Lee-Stone/orangepi-ros2-car/assets/44.png

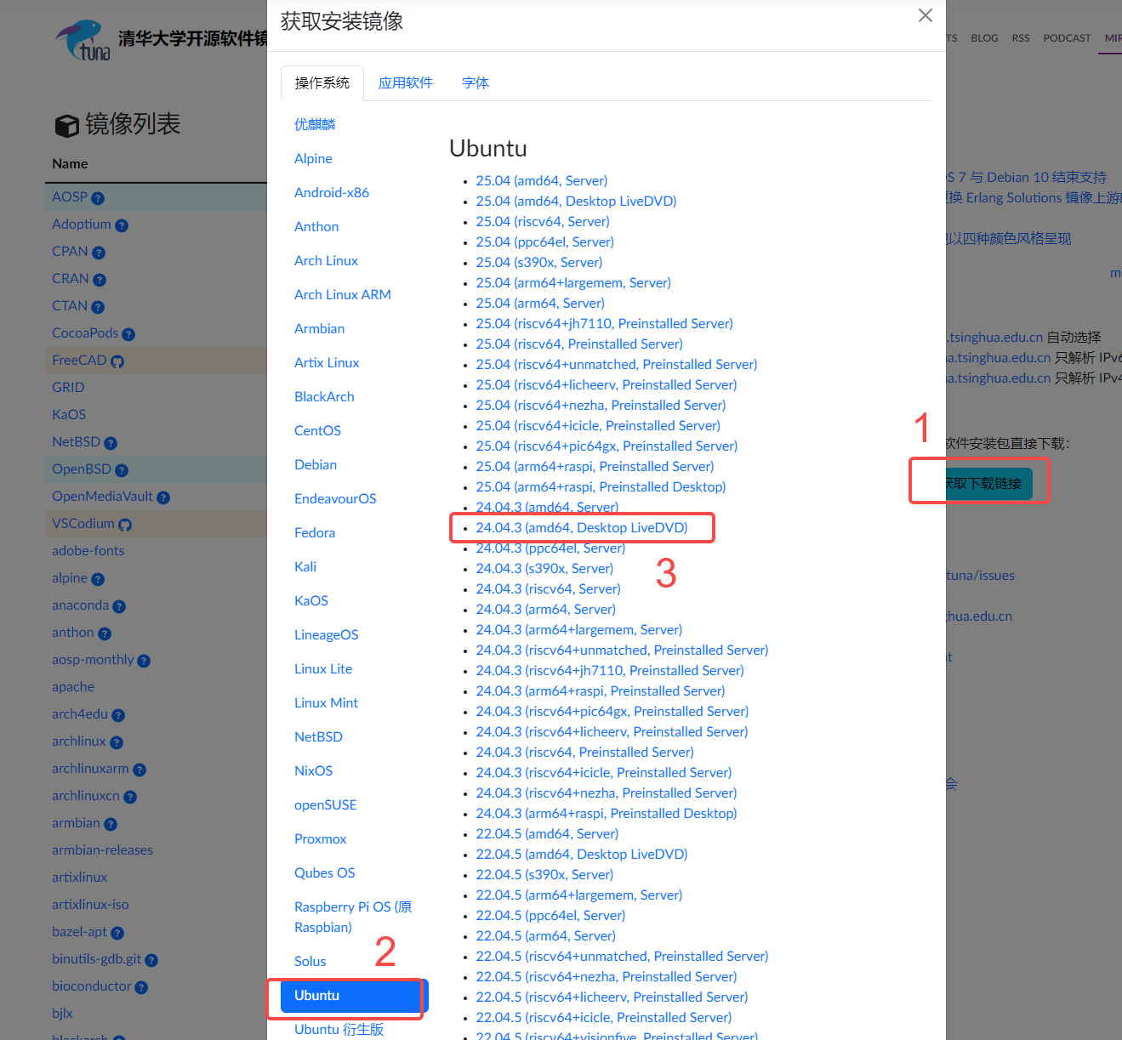
assets/44.png
