Lee-Stone/orangepi-ros2-car/assets/47.png

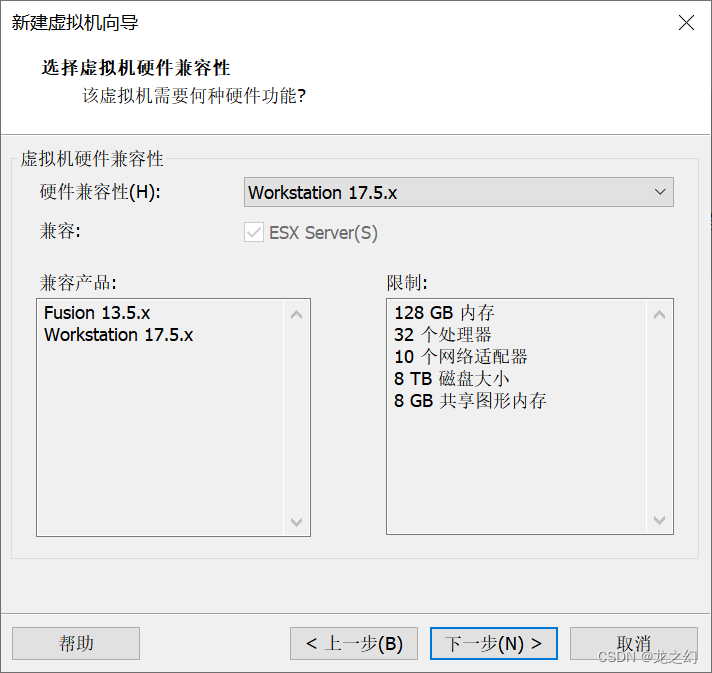
assets/47.png
