Lee-Stone/orangepi-ros2-car/assets/89.png

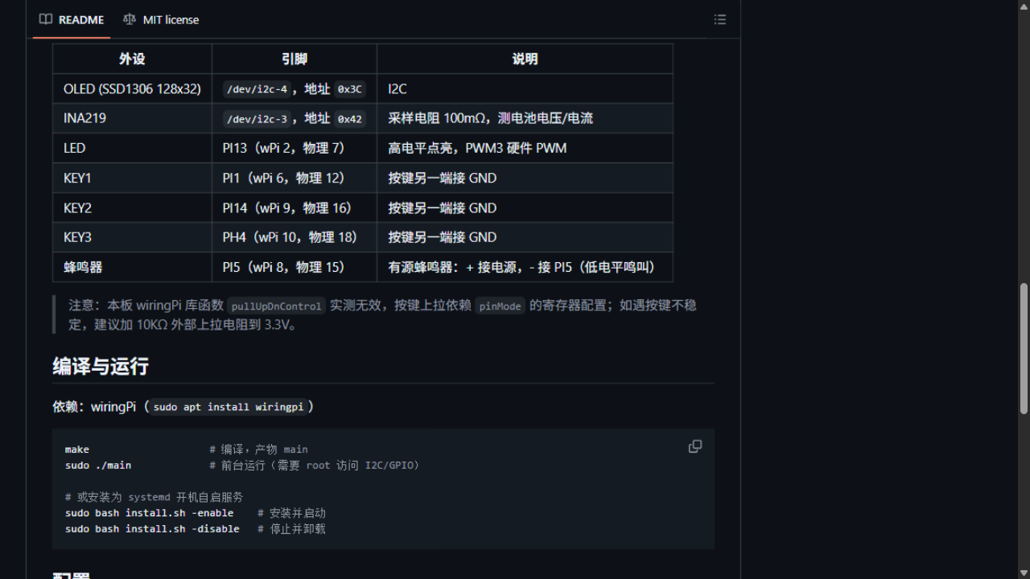
assets/89.png
