Lee-Stone/orangepi-ros2-car/assets/145.png

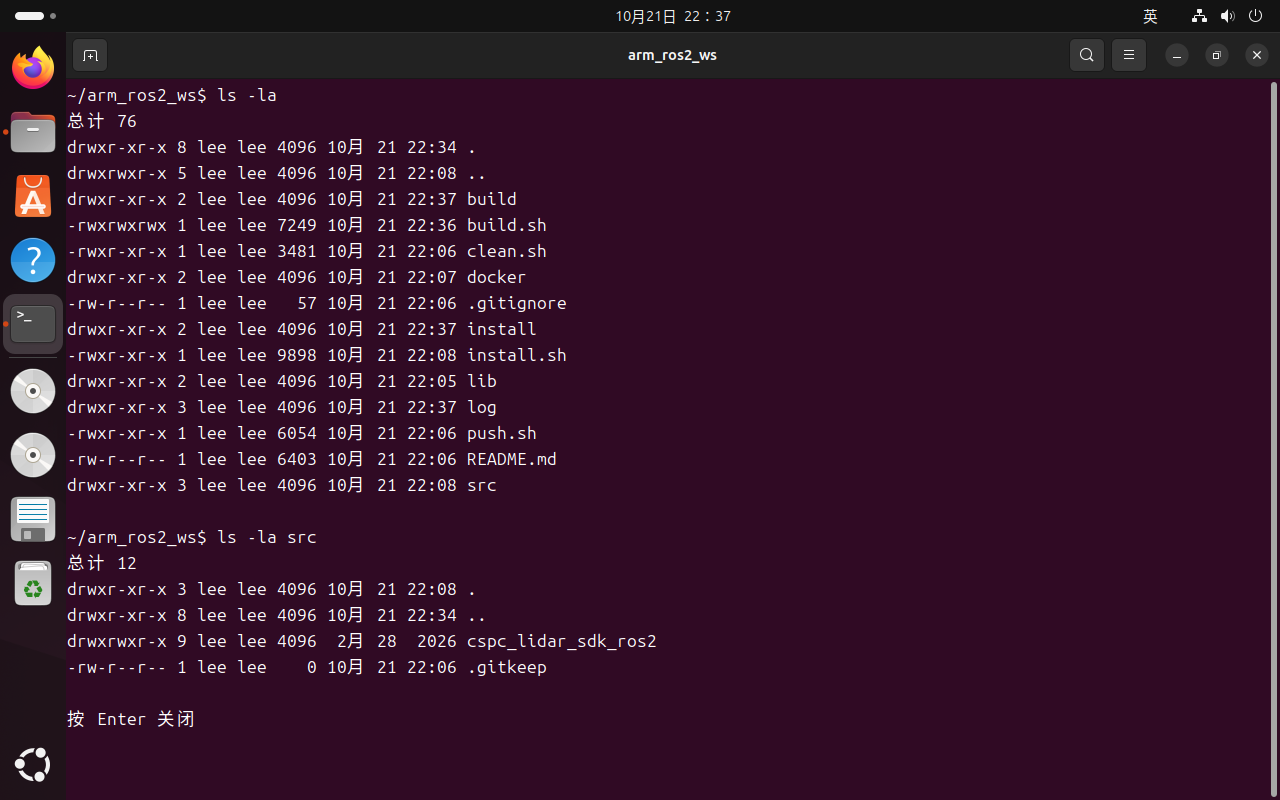
assets/145.png
