Lee-Stone/orangepi-ros2-car/assets/149.png

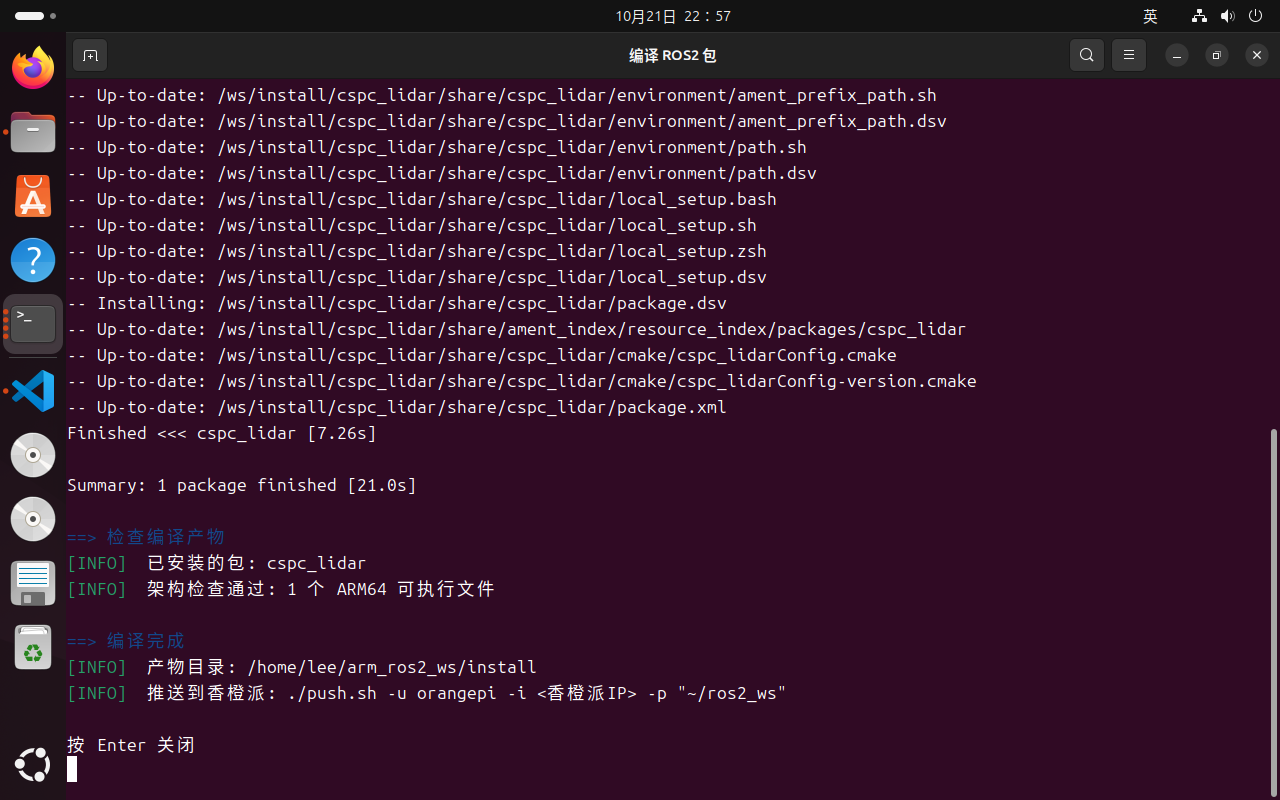
assets/149.png
