Lee-Stone/orangepi-ros2-car/assets/230.png

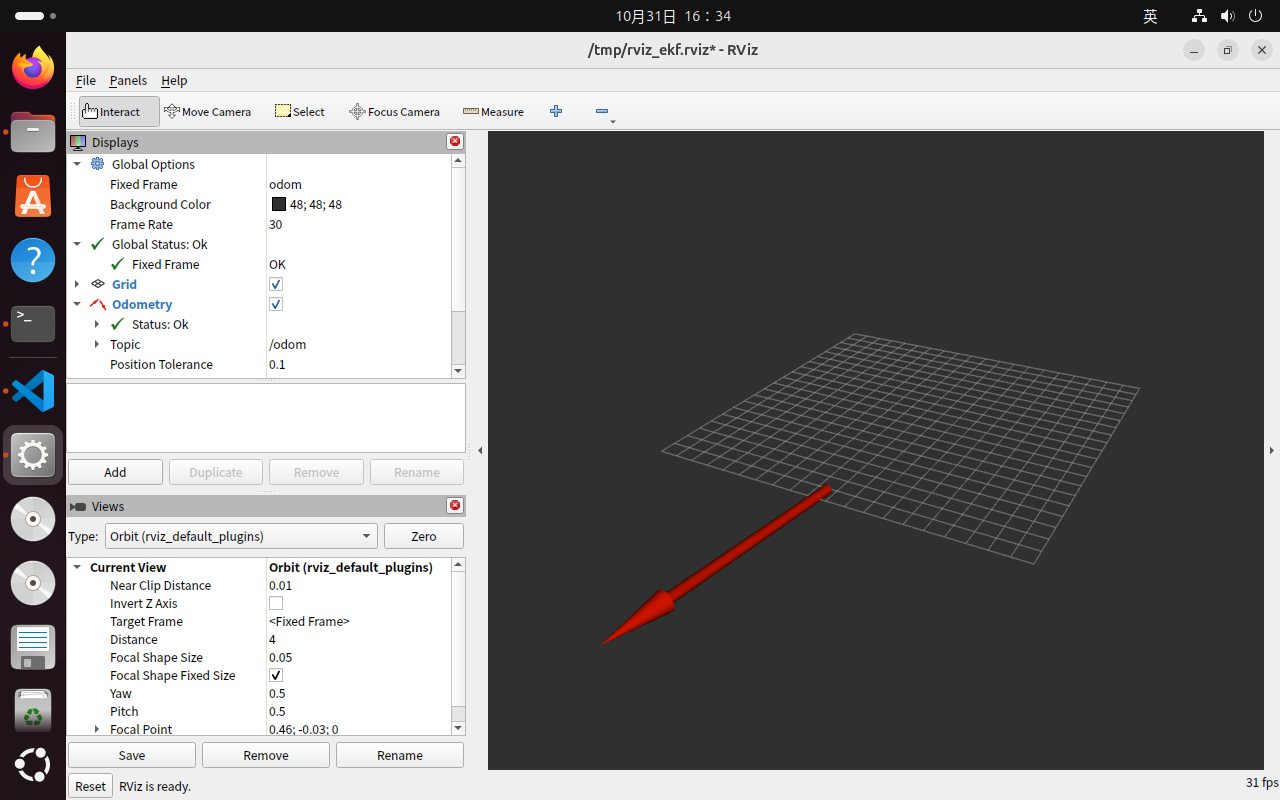
assets/230.png
