Lee-Stone/orangepi-ros2-car/assets/258.png

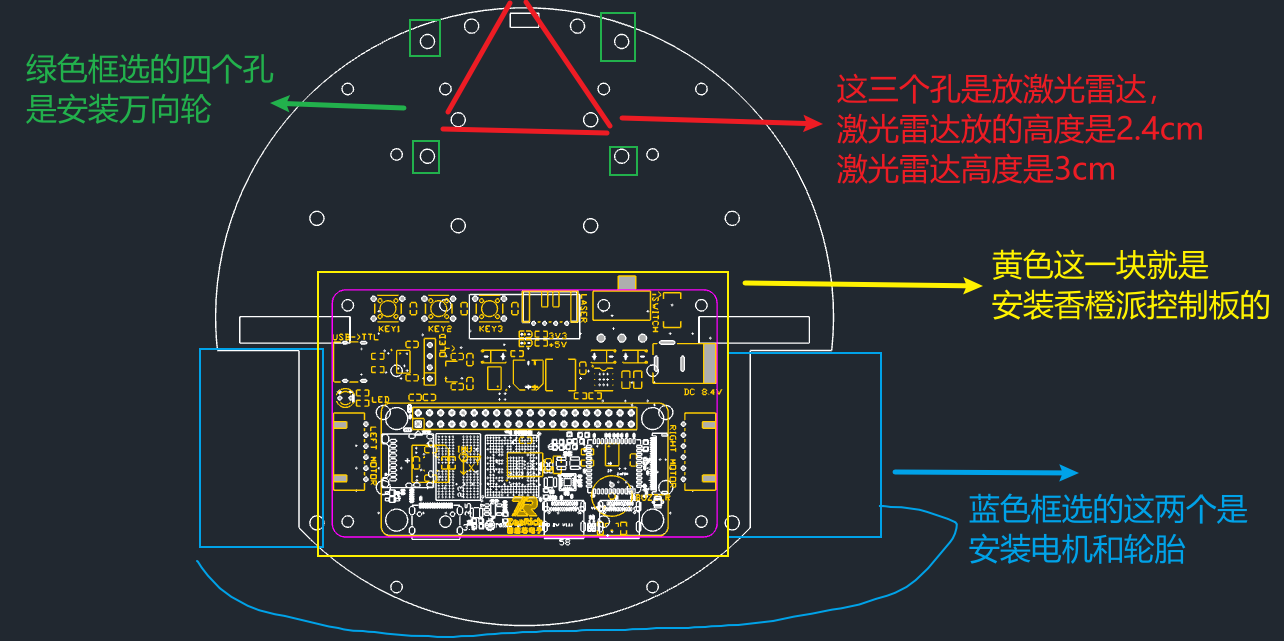
assets/258.png
