Lee-Stone/orangepi-ros2-car/assets/259.png

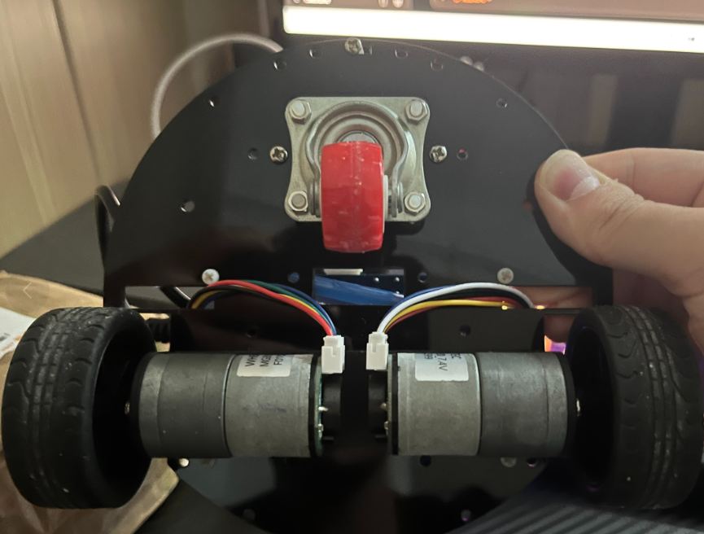
assets/259.png
