Lee-Stone/orangepi-ros2-car/assets/262.png

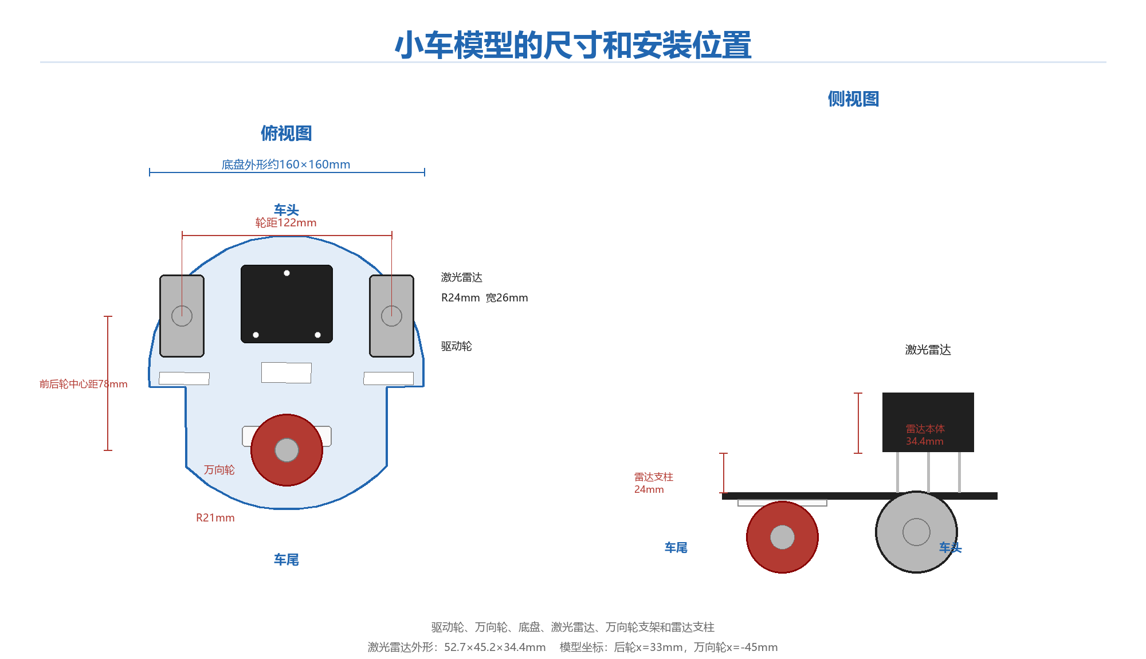
assets/262.png
