Lee-Stone/orangepi-ros2-car/assets/309.png

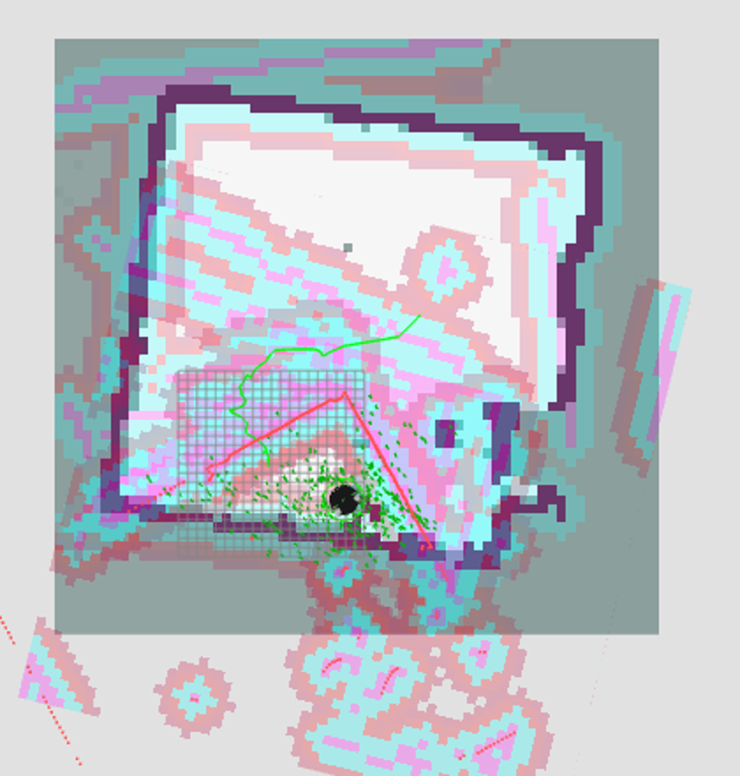
assets/309.png
