Lee-Stone/orangepi-ros2-car/assets/322.png

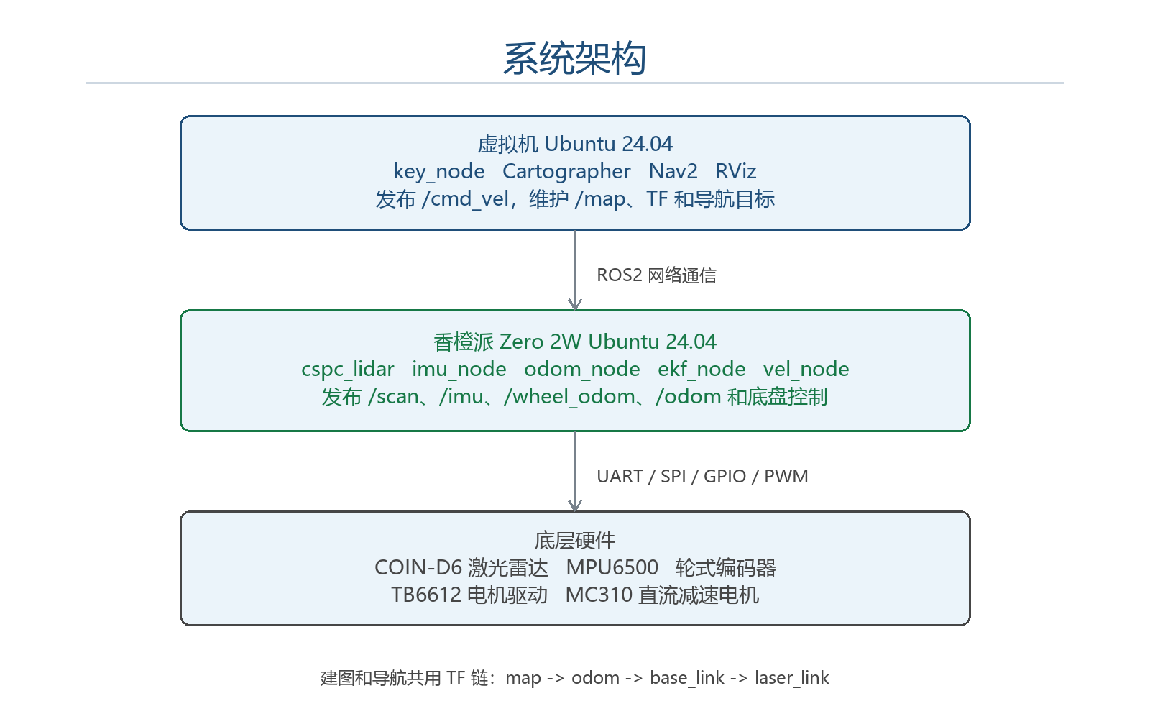
assets/322.png
