Lee-Stone/orangepi-ros2-car/vmware_ros2_ws/src/car_pkg/urdf/base_plate.stl

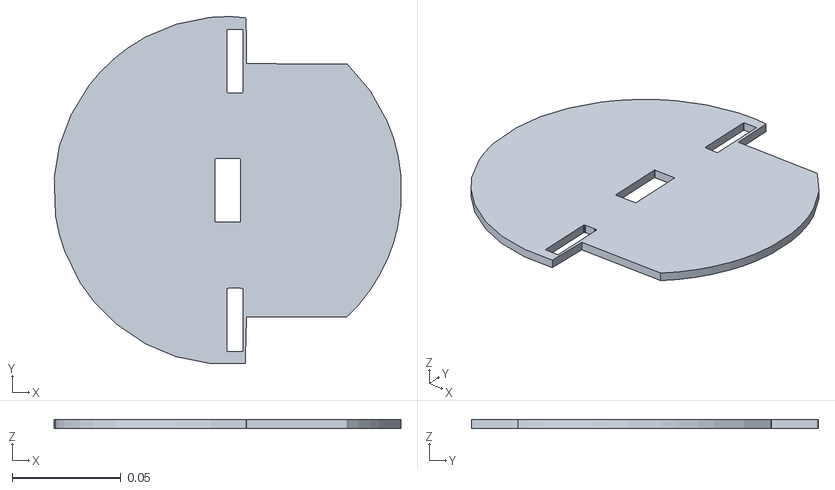
[picture p312: CAD file, 2026-11-04]
vmware_ros2_ws/src/car_pkg/urdf/base_plate.stl
0.159 x 0.159 x 0.004
