Lee-Stone/orangepi-ros2-car/hardware/香橙派ROS2控制板-原理图.pdf

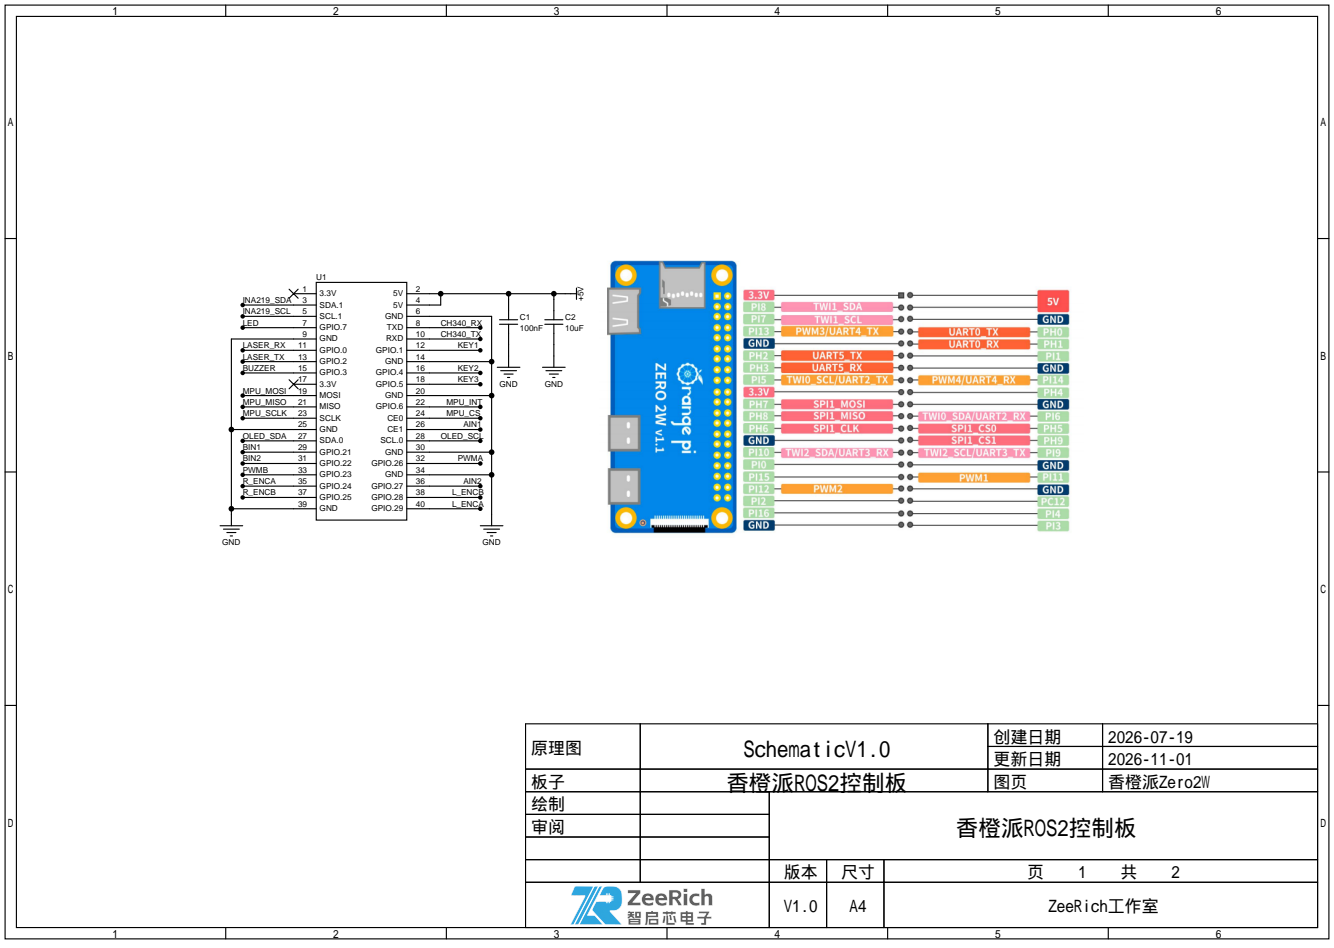
[picture p313: page 1]

原理图 | SchematicV1.0 | 创建日期 | 2026-07-19

更新日期 | 2026-11-01

板子 | 香橙派ROS2控制板 | 图页 | 香橙派Zero2W
绘制 | | 香橙派ROS2控制板
审阅

V1.0 | A4 | ZeeRich工作室

USB转串口 | 电流采样电路 | 用户按键 | 电机驱动 GND

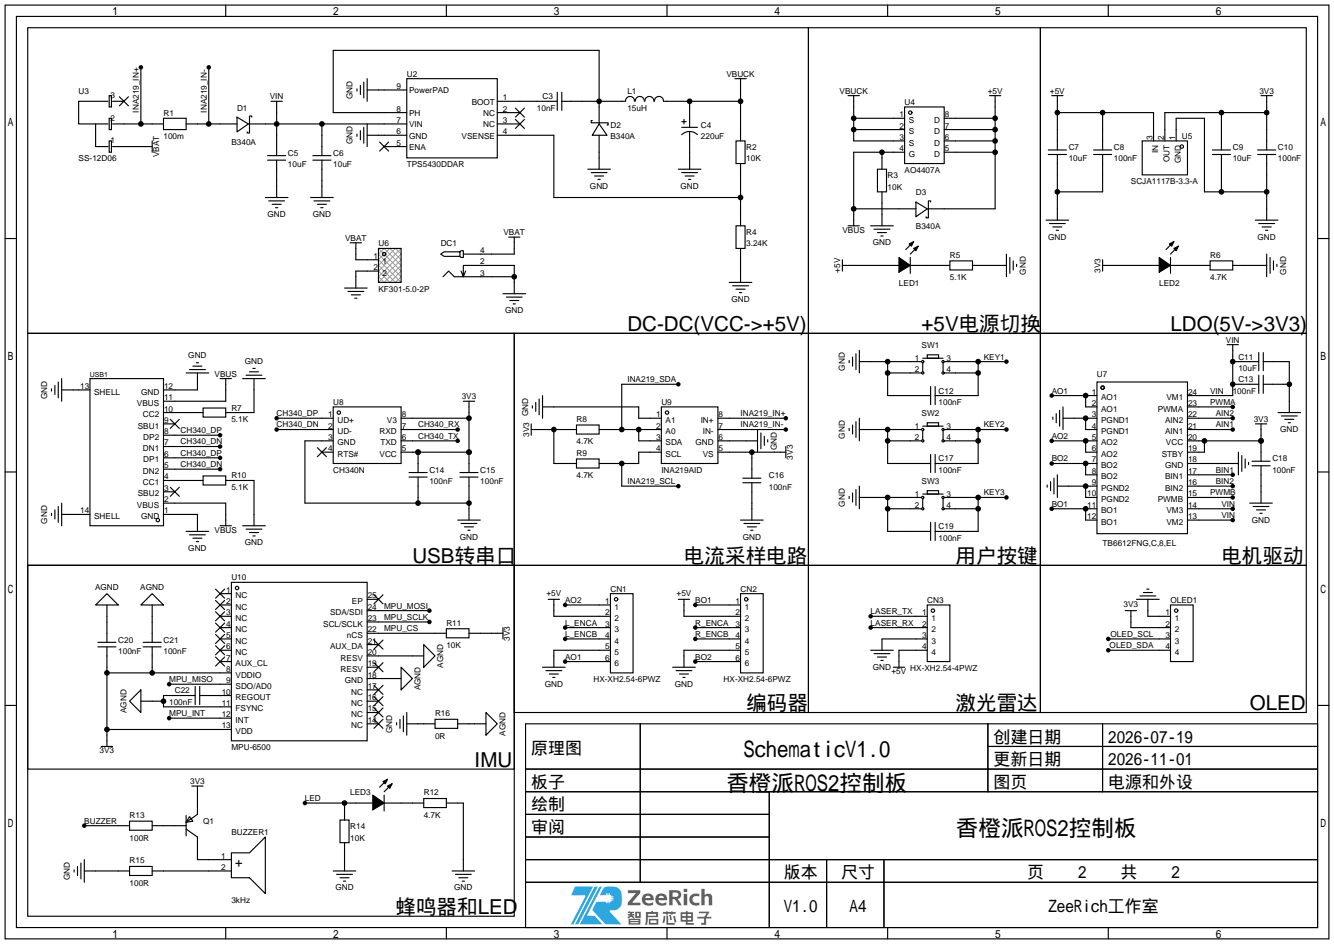
[picture p314: page 2]

原理图 | SchematicV1.0 | 创建日期 | 2026-07-19
板子 | 香橙派ROS2控制板 | 图页 | 电源和外设
绘制 | | 香橙派ROS2控制板
审阅

更新日期 | 2026-11-01

V1.0 | A4 | ZeeRich工作室
