Lee-Stone/orangepi-ros2-car/hardware/香橙派Zero2W-原理图.pdf

D | D

# 1.Note that the voltage of SOC GPIO must matches the

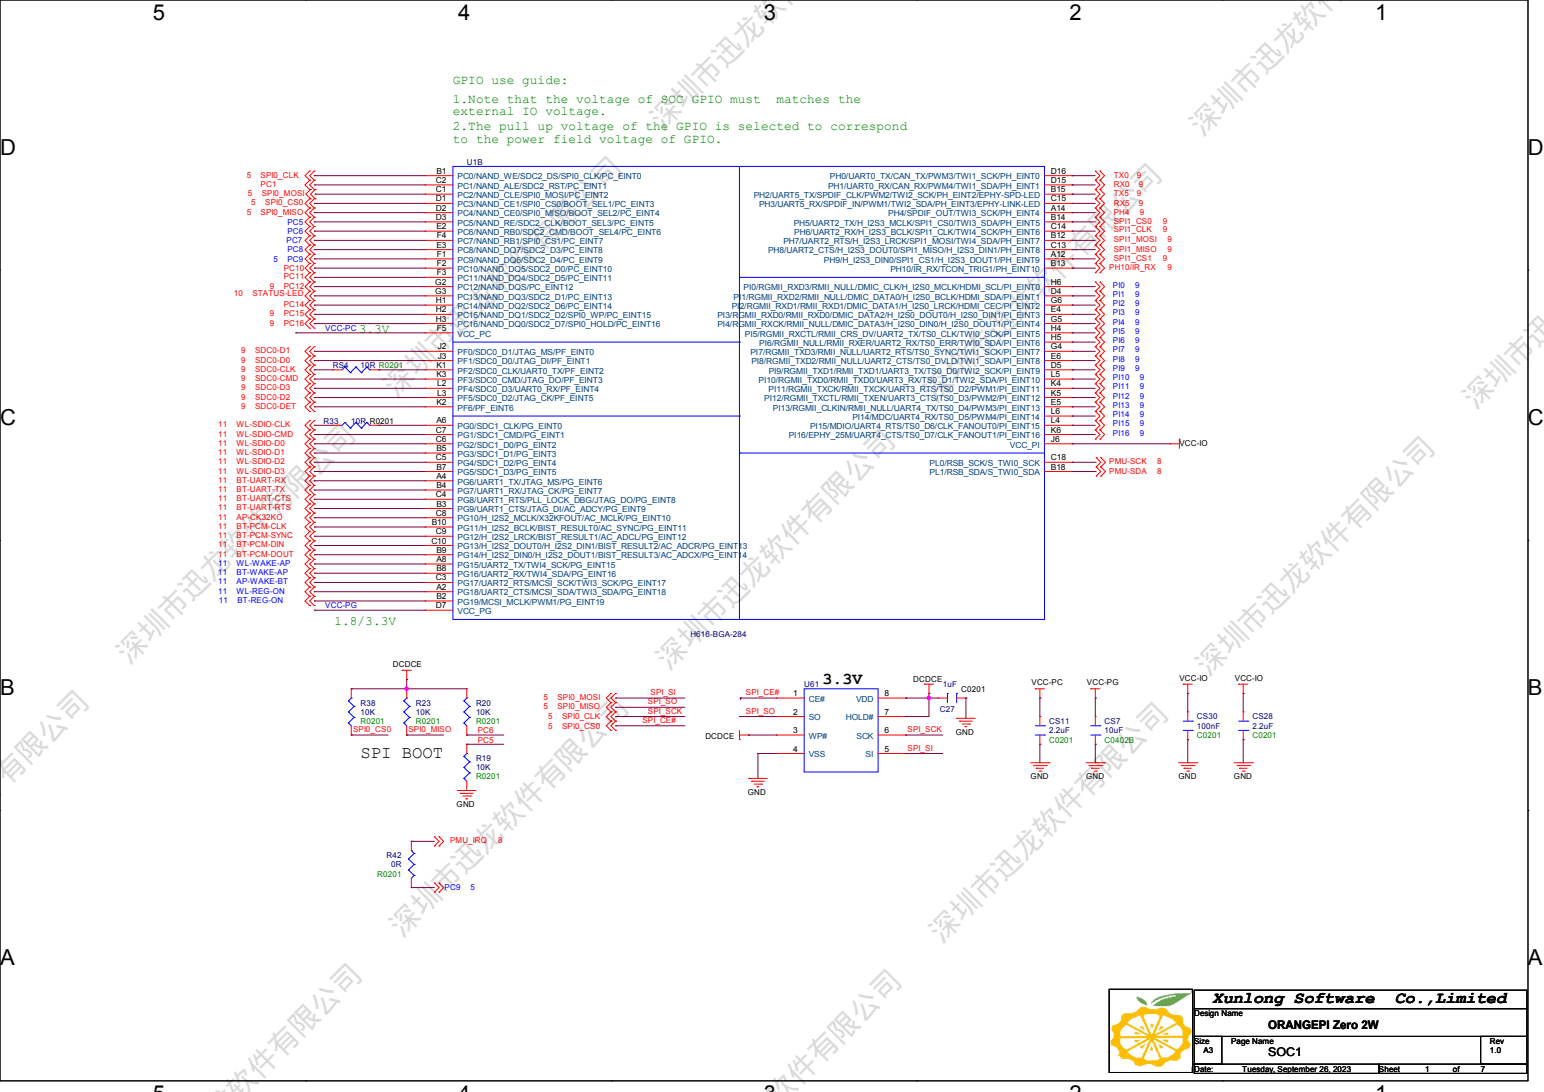
[picture p315: page 1]

深圳市迅龙软件有限公司 深圳市迅龙软件有限公司 深圳市迅龙软件有限公司 深圳市迅龙软件有限公司 深圳市迅龙软件有限公司 深圳市迅龙软件有限公司 深圳市迅龙软件有限公司 深圳市迅龙软件有限公司 深圳市迅龙软件有限公司 深圳市迅龙软件有限公司 深圳市迅龙软件有限公司 深圳市迅龙软件有限公司 深圳市迅龙软件有限公司 深圳市迅龙软件有限公司 深圳市迅龙软件有限公司

GPIO use guide:
external IO voltage.
2.The pull up voltage of the GPIO is selected to correspond
to the power field voltage of GPIO.

Xunlong Software Co.,Limited

D | D

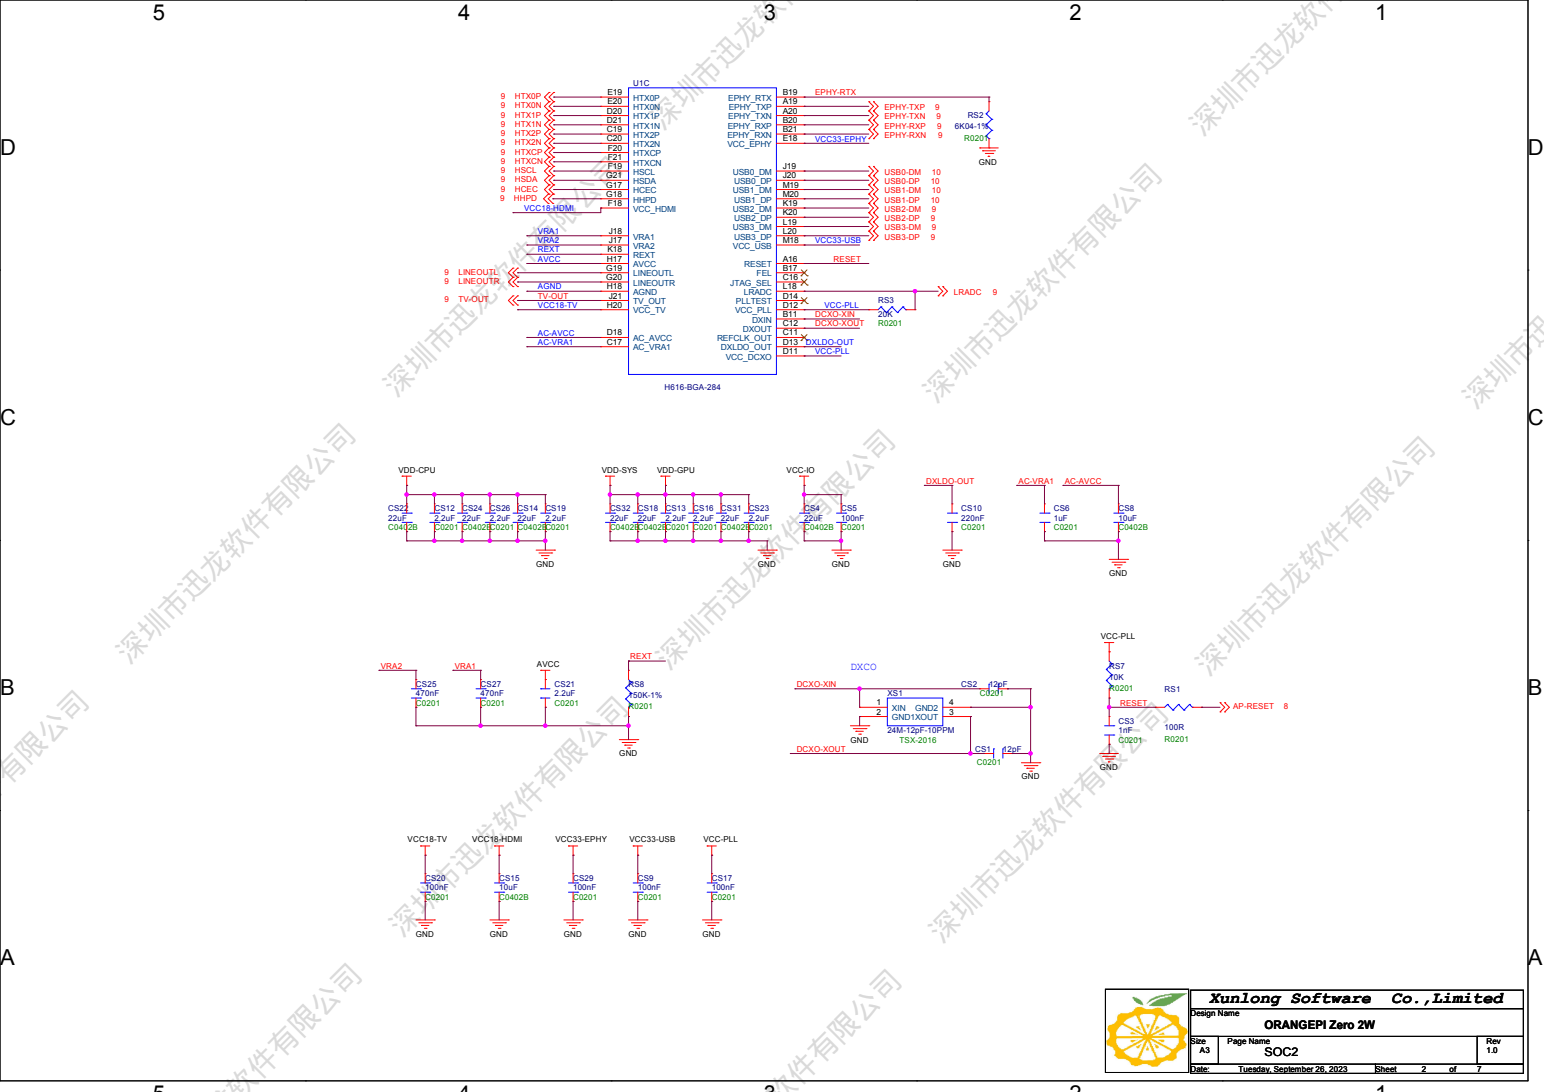
[picture p316: page 2]

深圳市迅龙软件有限公司 深圳市迅龙软件有限公司 深圳市迅龙软件有限公司 深圳市迅龙软件有限公司 深圳市迅龙软件有限公司 深圳市迅龙软件有限公司 深圳市迅龙软件有限公司 深圳市迅龙软件有限公司 深圳市迅龙软件有限公司 深圳市迅龙软件有限公司 深圳市迅龙软件有限公司 深圳市迅龙软件有限公司 深圳市迅龙软件有限公司 深圳市迅龙软件有限公司 深圳市迅龙软件有限公司

Xunlong Software Co.,Limited

D | D

# LPDDR4

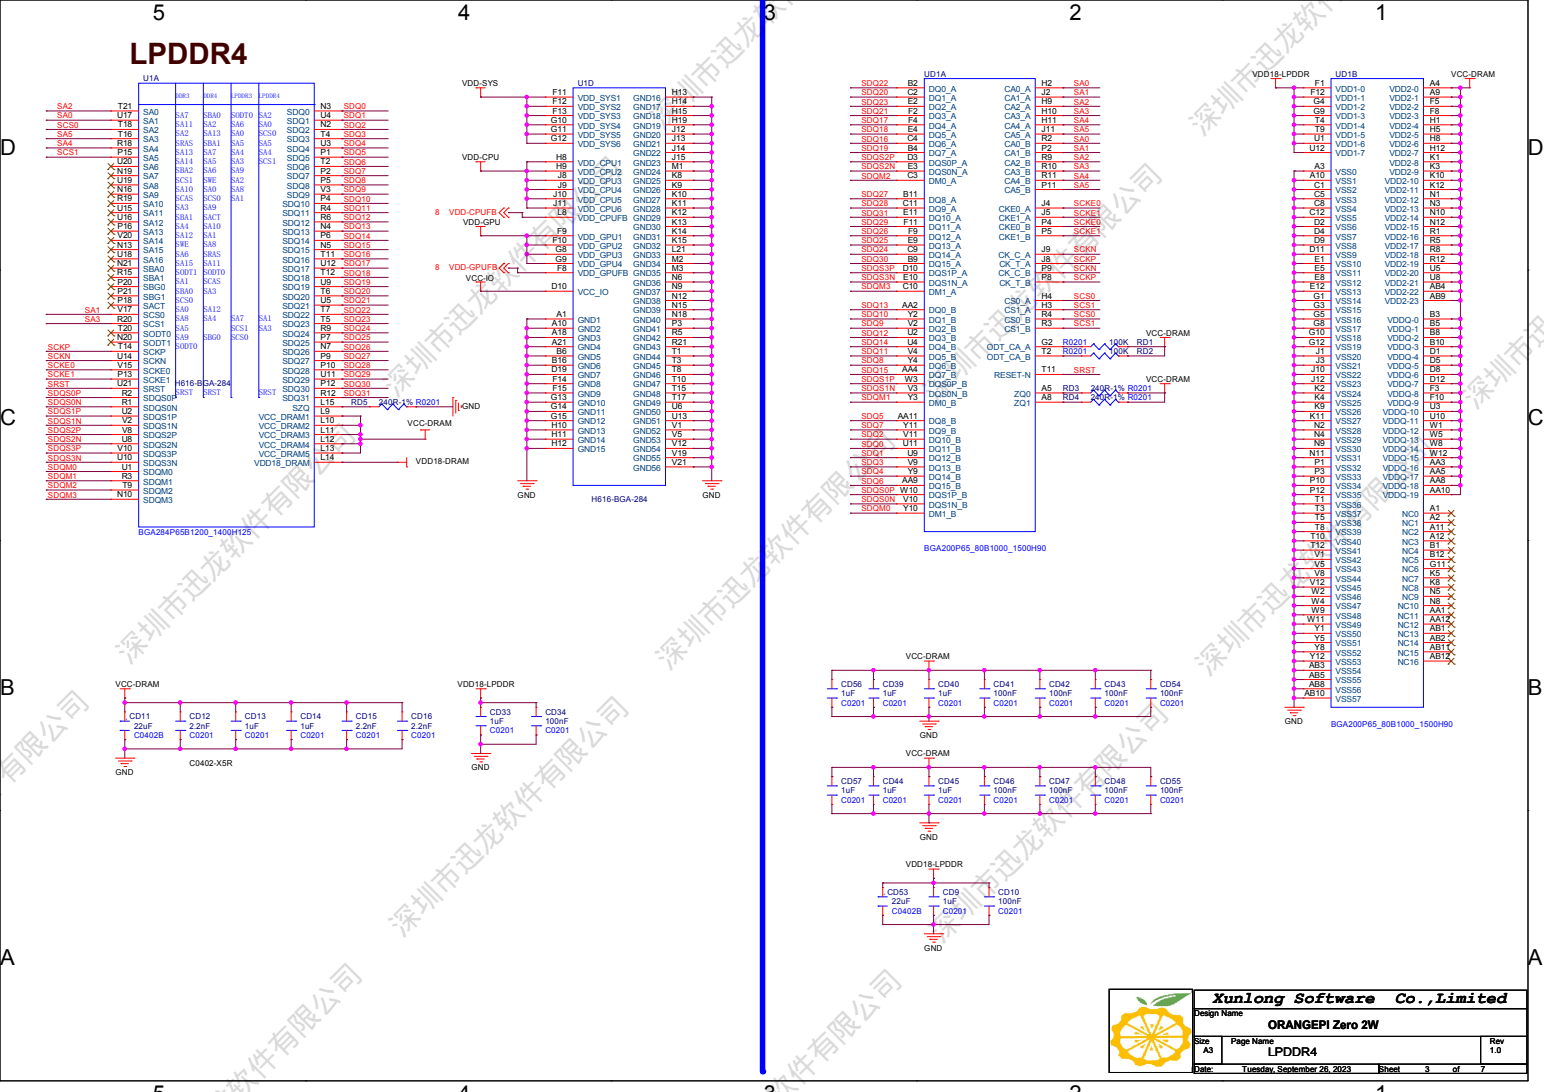
[picture p317: page 3]

深圳市迅龙软件有限公司 深圳市迅龙软件有限公司 深圳市迅龙软件有限公司 深圳市迅龙软件有限公司 深圳市迅龙软件有限公司 深圳市迅龙软件有限公司 深圳市迅龙软件有限公司 深圳市迅龙软件有限公司 深圳市迅龙软件有限公司 深圳市迅龙软件有限公司 深圳市迅龙软件有限公司 深圳市迅龙软件有限公司 深圳市迅龙软件有限公司 深圳市迅龙软件有限公司 深圳市迅龙软件有限公司

Xunlong Software Co.,Limited

### 1.0uH@2ADCR<0.1R

# AXP313A

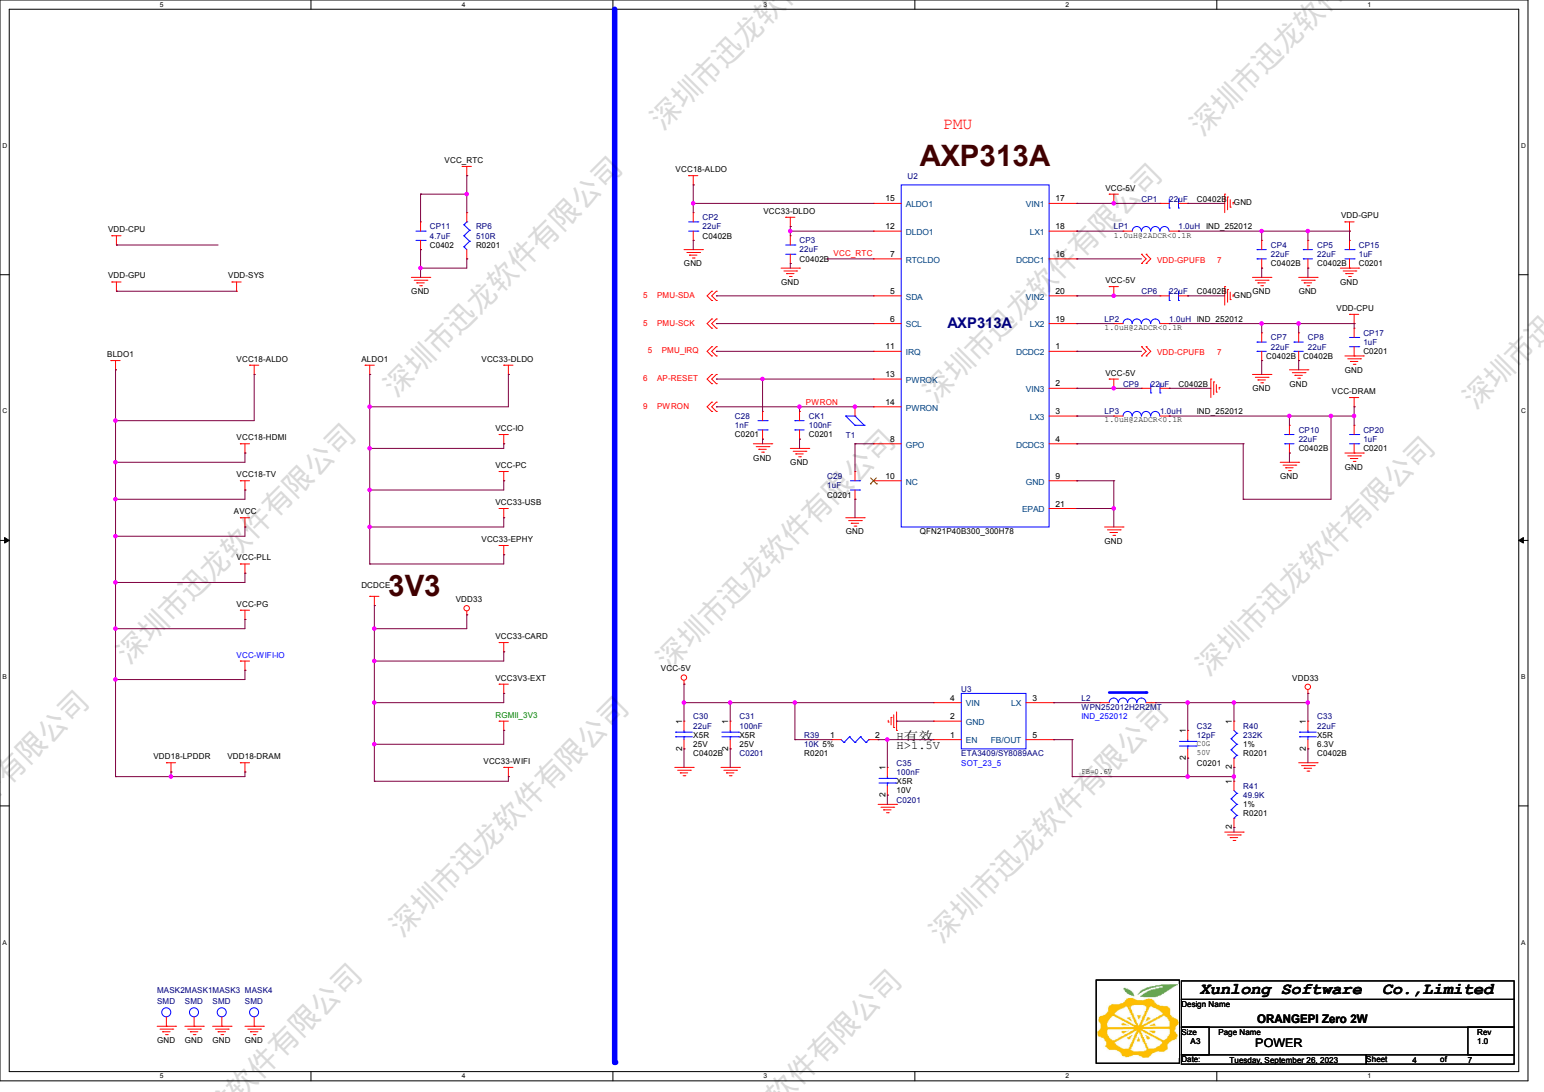
[picture p318: page 4]

深圳市迅龙软件有限公司 深圳市迅龙软件有限公司 深圳市迅龙软件有限公司 深圳市迅龙软件有限公司 深圳市迅龙软件有限公司 深圳市迅龙软件有限公司 深圳市迅龙软件有限公司 深圳市迅龙软件有限公司 深圳市迅龙软件有限公司 深圳市迅龙软件有限公司 深圳市迅龙软件有限公司 深圳市迅龙软件有限公司 深圳市迅龙软件有限公司 深圳市迅龙软件有限公司 深圳市迅龙软件有限公司

Xunlong Software Co.,Limited

D | D

# T CARD

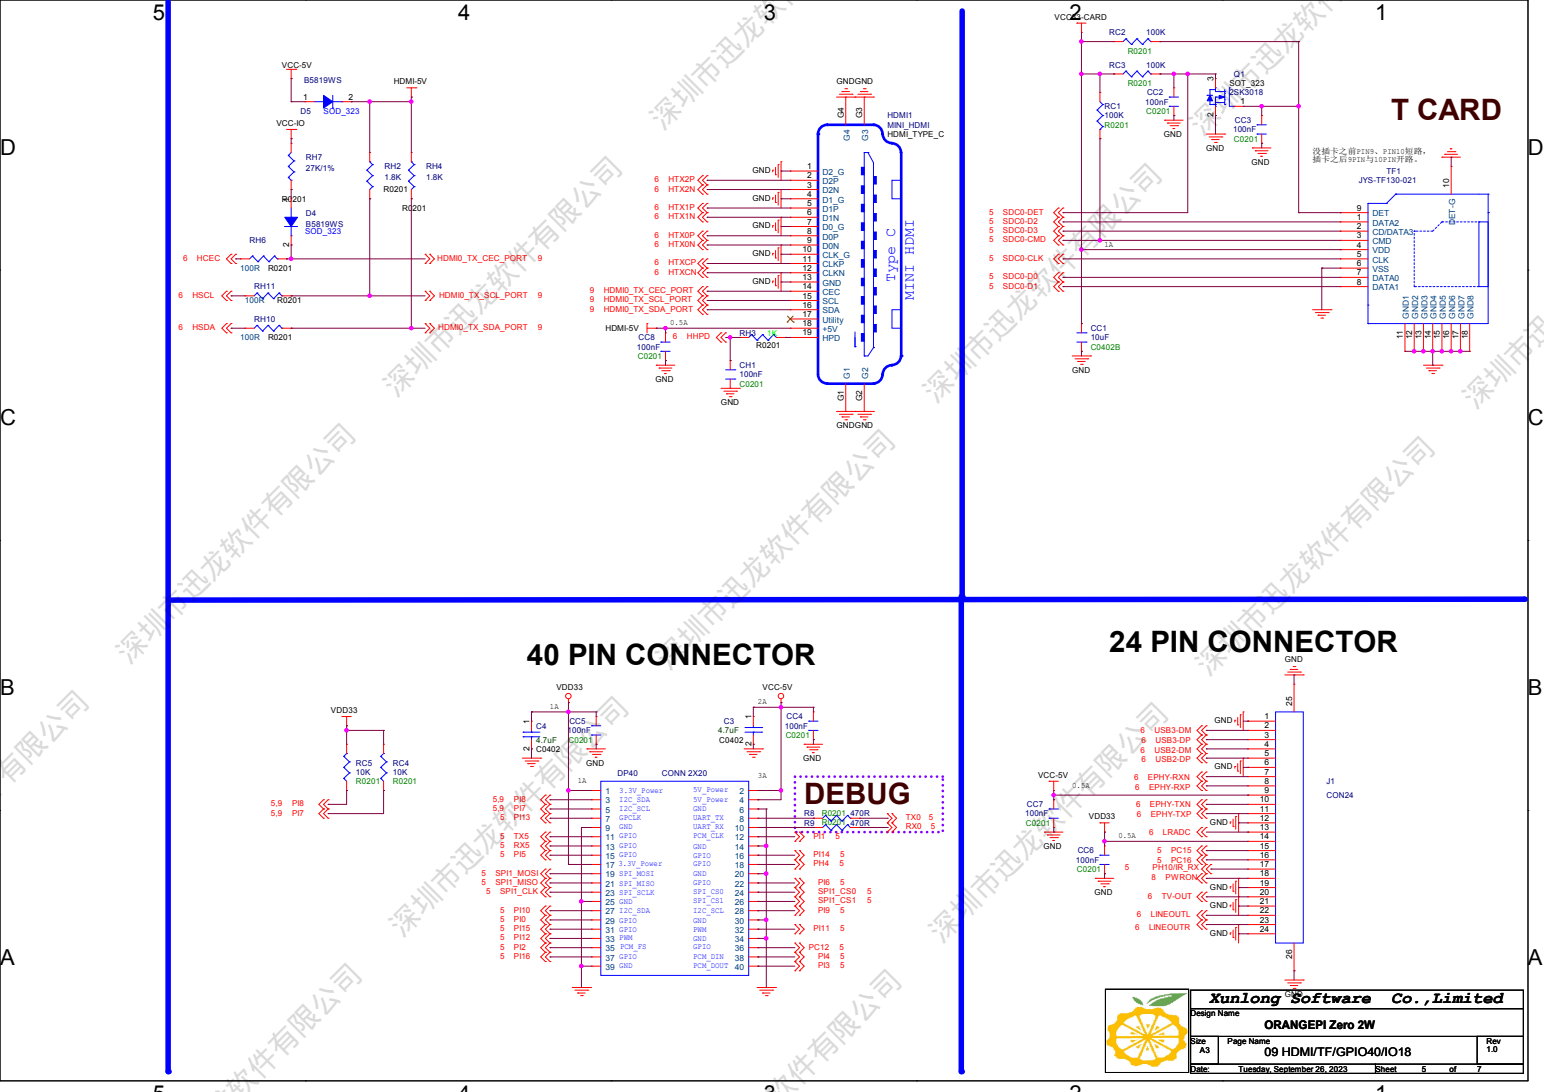
[picture p319: page 5]

深圳市迅龙软件有限公司 深圳市迅龙软件有限公司 深圳市迅龙软件有限公司 深圳市迅龙软件有限公司 深圳市迅龙软件有限公司 深圳市迅龙软件有限公司 深圳市迅龙软件有限公司 深圳市迅龙软件有限公司 深圳市迅龙软件有限公司 深圳市迅龙软件有限公司 深圳市迅龙软件有限公司 深圳市迅龙软件有限公司 深圳市迅龙软件有限公司 深圳市迅龙软件有限公司 深圳市迅龙软件有限公司

24 PIN CONNECTOR 40 PIN CONNECTOR

Xunlong Software Co.,Limited

D

## GND

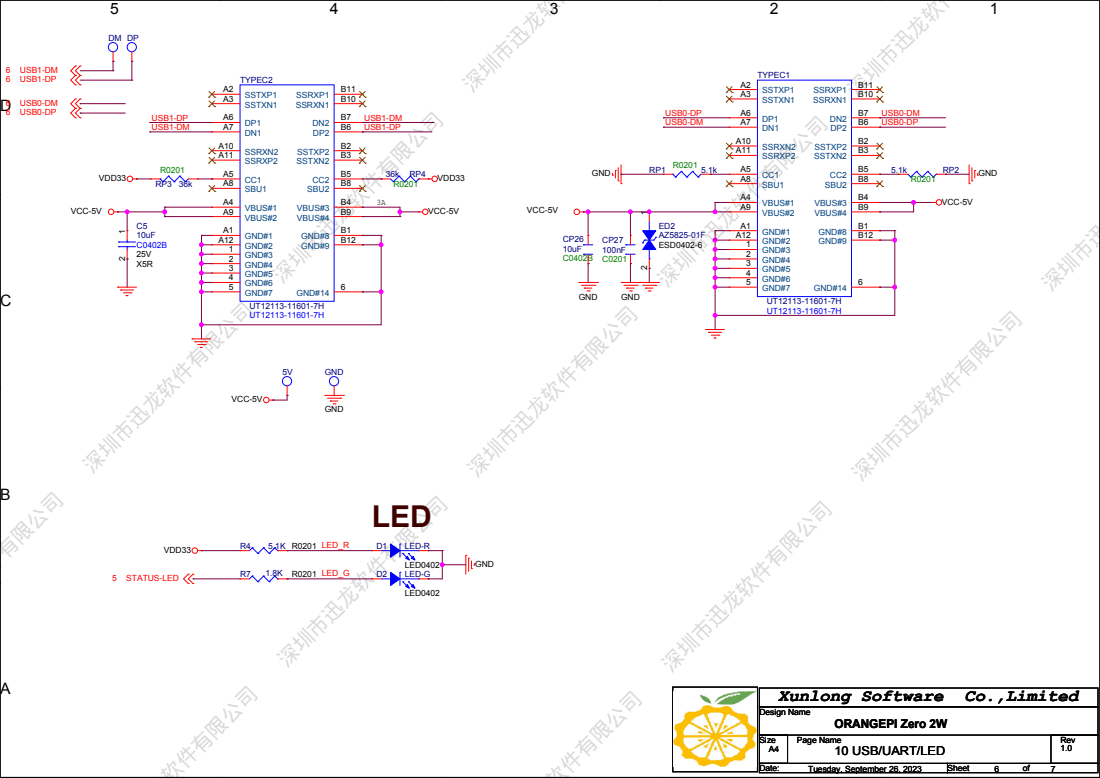
[picture p320: page 6]

深圳市迅龙软件有限公司 深圳市迅龙软件有限公司 深圳市迅龙软件有限公司 深圳市迅龙软件有限公司 深圳市迅龙软件有限公司 深圳市迅龙软件有限公司 深圳市迅龙软件有限公司 深圳市迅龙软件有限公司 深圳市迅龙软件有限公司 深圳市迅龙软件有限公司 深圳市迅龙软件有限公司 深圳市迅龙软件有限公司 深圳市迅龙软件有限公司 深圳市迅龙软件有限公司 深圳市迅龙软件有限公司

Xunlong Software Co.,Limited

D | D

# WIFI+BT

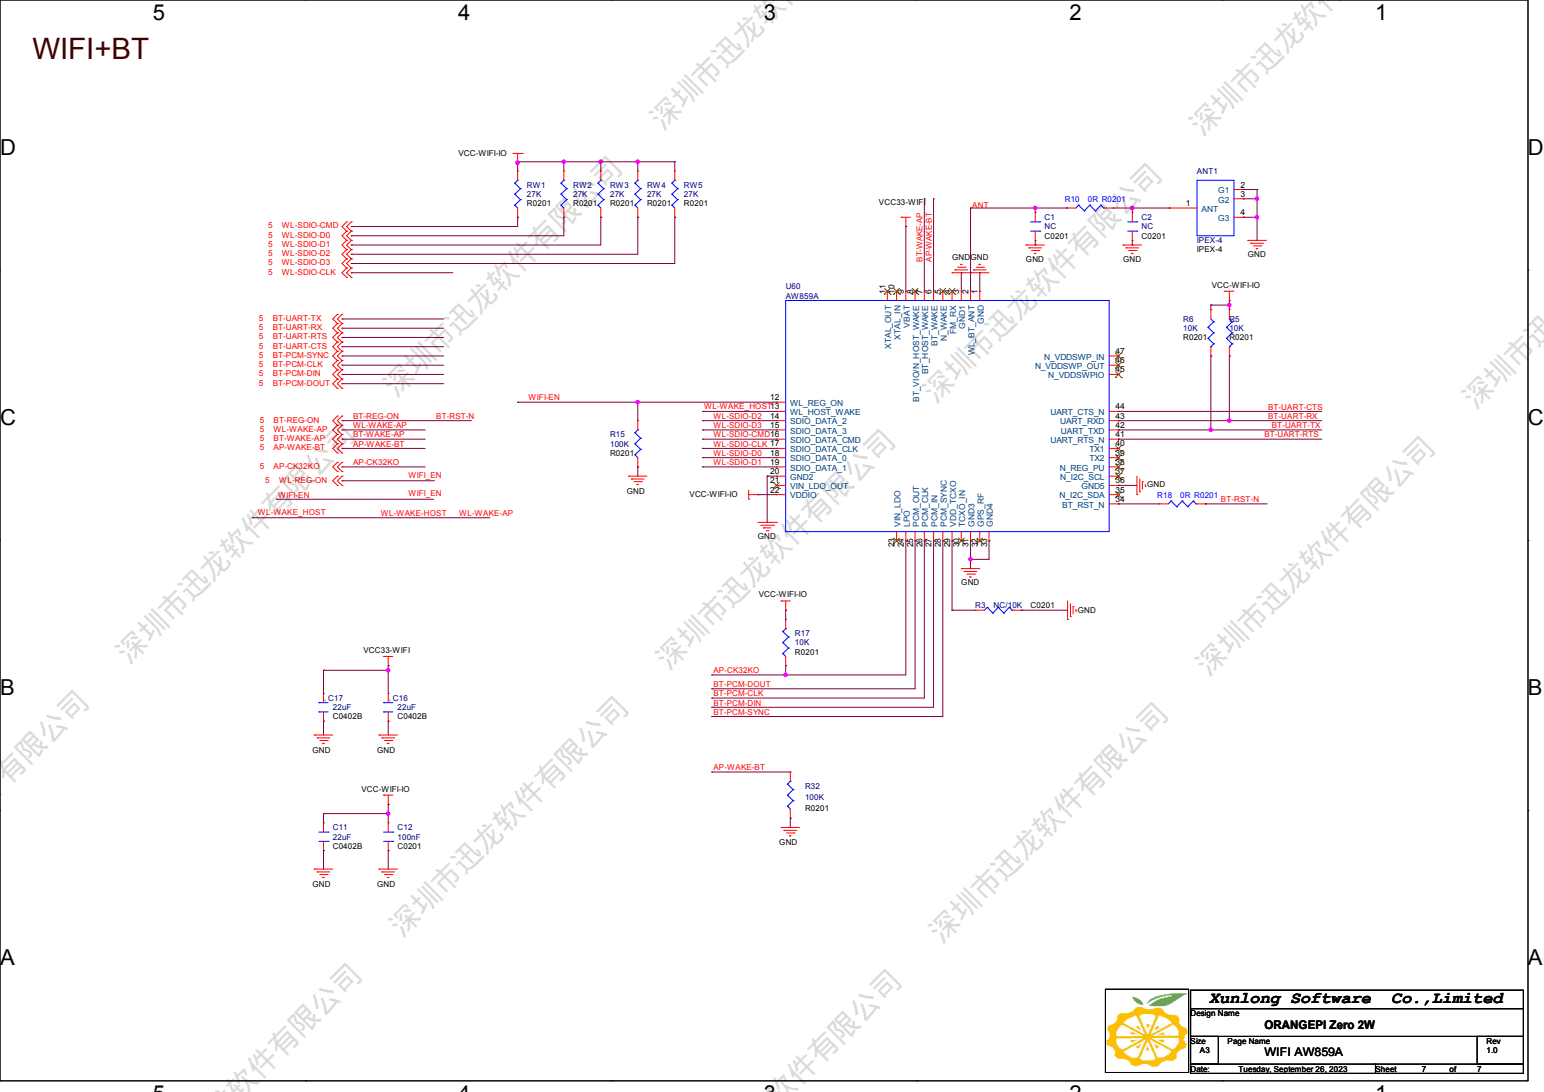
[picture p321: page 7]

深圳市迅龙软件有限公司 深圳市迅龙软件有限公司 深圳市迅龙软件有限公司 深圳市迅龙软件有限公司 深圳市迅龙软件有限公司 深圳市迅龙软件有限公司 深圳市迅龙软件有限公司 深圳市迅龙软件有限公司 深圳市迅龙软件有限公司 深圳市迅龙软件有限公司 深圳市迅龙软件有限公司 深圳市迅龙软件有限公司 深圳市迅龙软件有限公司 深圳市迅龙软件有限公司 深圳市迅龙软件有限公司

Xunlong Software Co.,Limited
