Lee-Stone/orangepi-ros2-car/(commit log)

2026-11-04 Include Orange Pi source packages
    [test_ros_robot_localization_listener.yaml]
2026-11-04 Include VM workspace source packages
    [base_plate.stl, car_model.urdf]
2026-11-07 Update assembly steps, BOM, and quick start links
